wzh0531/nuedc-2026-h-ball-control/THIRD_PARTY_NOTICES.md

# 第三方软件与资料声明

本仓库包含或依赖以下第三方内容。其版权属于原作者，使用者应同时遵守相应许可条款。

## 逐飞 MSPM0G3507 开源库

- 版权所有 © 2022 成都逐飞科技有限公司（SEEKFREE）
- 许可证：GNU General Public License v3.0 or later
- 位置：`firmware/mspm0/libraries/zf_*`、部分 `project/user` 文件及相关工程配置
- 原始版权声明已保留在源文件头部。

## Texas Instruments MSPM0 SDK / DriverLib

- 版权所有 © Texas Instruments Incorporated
- 位置：`firmware/mspm0/libraries/sdk`
- 各文件适用的 BSD 类许可或 TI 许可声明以文件头部原文为准。

## Arm CMSIS

- 版权所有 © Arm Limited（及相关贡献者）
- 位置：`firmware/mspm0/libraries/sdk/third_party/CMSIS`
- 各文件许可声明以文件头部原文为准。

## MaixPy / Sipeed 运行时

`firmware/maixcam` 中的程序调用 MaixPy API，但仓库不分发 MaixPy 固件本身。MaixPy
及设备固件遵循其上游许可条款。

## 赛题与模型

- `docs/reference/H题_车载平衡滚球运动控制系统.pdf` 为竞赛题目资料，仅为复现和学习归档；
- `firmware/maixcam/model_310817.cvimodel` 为本项目使用的部署模型；训练数据未随仓库发布。

如发现版权归属或许可标注不完整，请提交 Issue 说明具体文件，本项目将及时补充或移除。
