wzh0531/nuedc-2026-h-ball-control/docs/flowcharts/01_主程序流程图.png

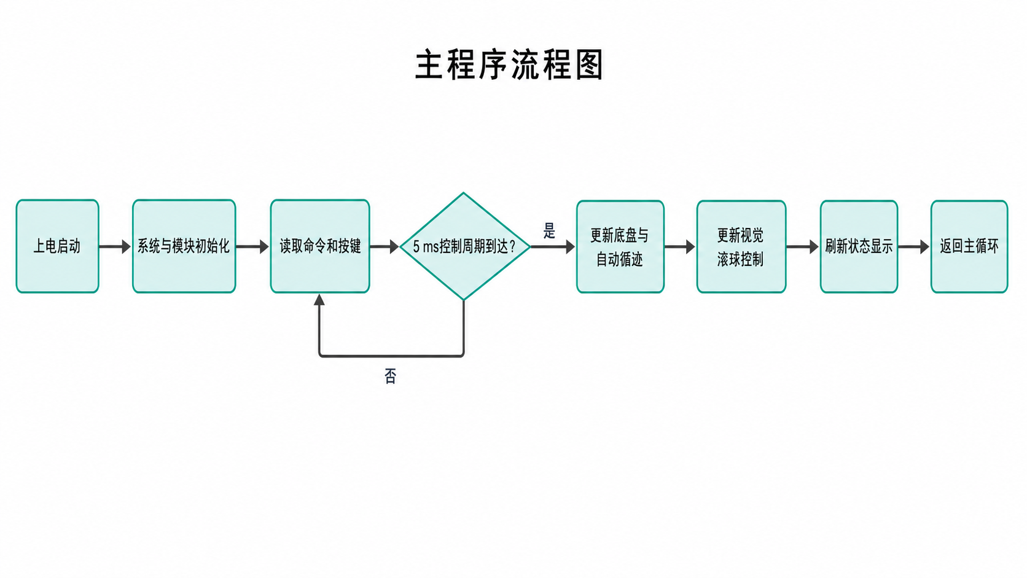
docs/flowcharts/01_主程序流程图.png
