wzh0531/nuedc-2026-h-ball-control/docs/flowcharts/02_自动循迹子程序.png

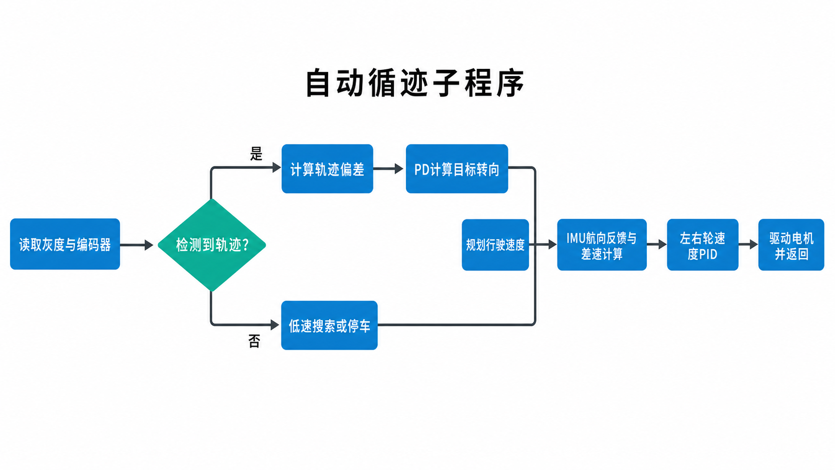
docs/flowcharts/02_自动循迹子程序.png
