wzh0531/nuedc-2026-h-ball-control/docs/flowcharts/03_视觉追踪子程序.png

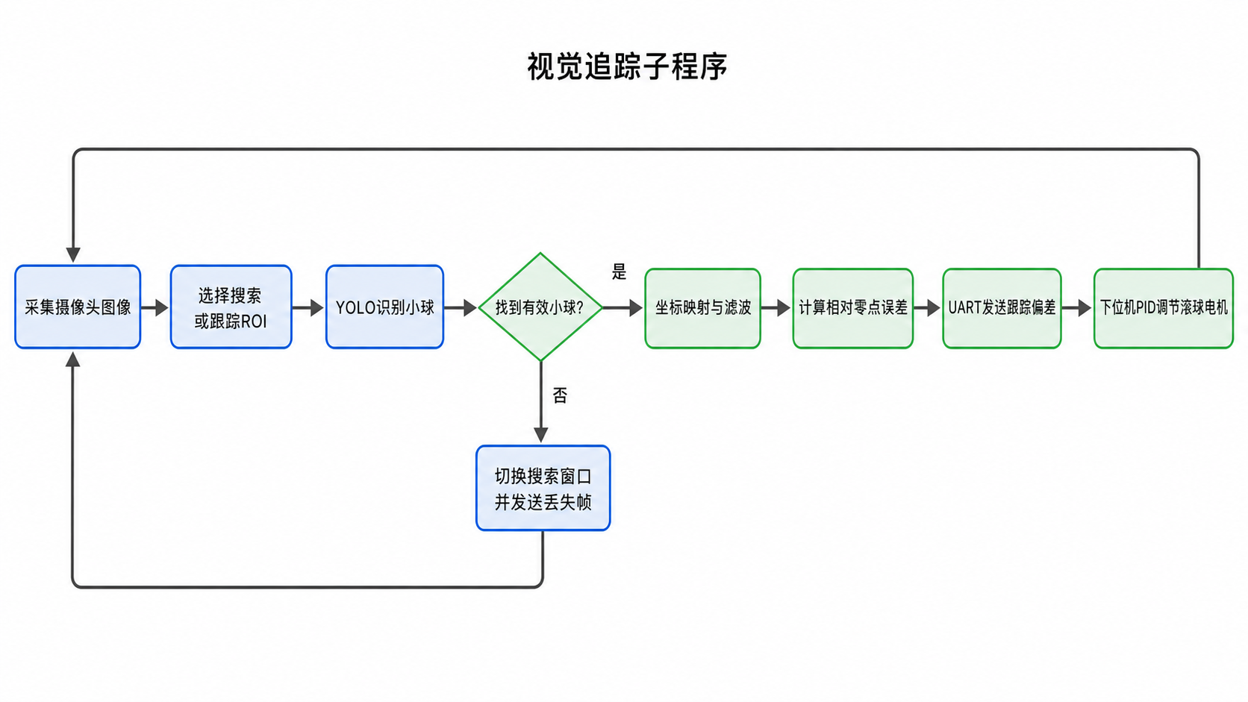
docs/flowcharts/03_视觉追踪子程序.png
