wzh0531/nuedc-2026-h-ball-control/docs/flowcharts/04_全局信号流向图.png

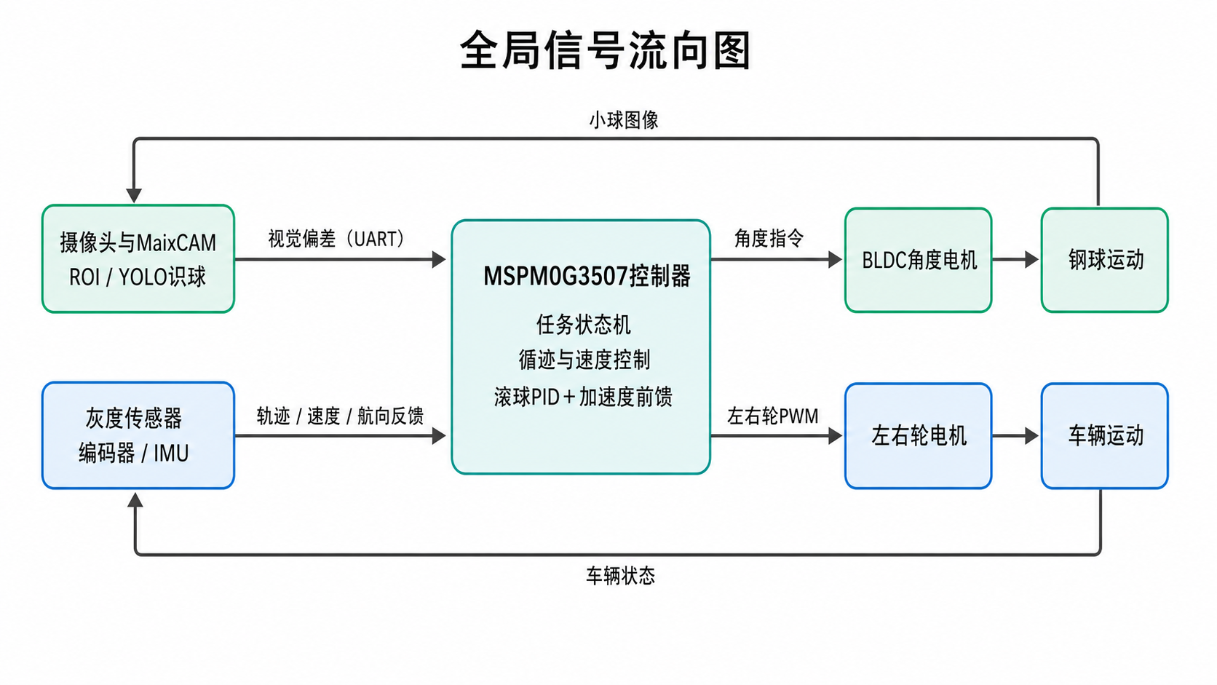
docs/flowcharts/04_全局信号流向图.png
