wzh0531/nuedc-2026-h-ball-control/docs/MSPM0_底盘固件使用与调试.md

# 2026 H 题 MSPM0G3507 底盘固件使用与调试手册

## 1. 当前交付状态

底盘固件位于：

`firmware/mspm0`

工程基线为 Keil MDK + ARMCLANG + 逐飞 MSPM0G3507 开源库。底盘代码只放在
`project/code` 与 `project/user`，未修改 `libraries` 底层。

当前已实现：

- 双轮差速底盘与扩展板板载 TB6612；
- MG513XP28_12V 电机，13 PPR、AB 双相四倍频；
- 左右轮 5 ms 独立速度 PI；
- 单前置感为八路灰度串行读取与循迹外环；
- IMU660RA Z 轴角速度内环；
- 任务 2～6 选择与底盘运动状态机；
- A 点停车、通过 B 后停车、越过 A 后停车；
- S 曲线限加速度、弯道降速、丢线与堵转保护；
- 四个板载按键、0.96 英寸 SSD1306 兼容 OLED、UART0 调参命令；
- Keil 工程、SysConfig 与完整编译依赖。

最后一次全量构建：

- MCU：MSPM0G3507；
- 工具链：ARMCLANG 6.21；
- 结果：0 Error、0 Warning；
- Flash 镜像估算：61,288 B，约 59.9 KiB；
- RAM：12,616 B，约 12.3 KiB。

编译通过只证明接口和链接正确。电机方向、编码器方向、灰度位序、轮径、
A/B 点距离和 PID 必须在实车上完成下面的标定。

## 2. 关键机械参数

| 参数 | 当前值 |
|---|---:|
| 底盘形式 | 双轮差速 |
| 建议车体 | 300 mm × 220 mm |
| 轮距 | 170 mm |
| 驱动轮有效直径 | 65 mm |
| 灰度阵列前伸量 | 轮轴前 80～100 mm |
| 电机减速比 | 28:1 |
| 编码器 | 13 PPR，AB 双相 |
| 软件计数方式 | A/B 两相双边沿，四倍频 |
| 每轮计数 | 13 × 4 × 28 = 1456 count/rev |
| 每计数距离 | 约 0.14025 mm |
| 额定理论线速度 | 约 1.021 m/s |

装车承载后轮胎会变形，实际轮径不能只用 65 mm 名义值。应通过定距行驶修正
`car_config.h` 中的 `CAR_METERS_PER_COUNT`。

## 3. 接线与资源表

### 3.1 电机与编码器

| 功能 | MSPM0 引脚 | 说明 |
|---|---|---|
| 左电机 PWM | PB14 / TIMA0_CH0 | 20 kHz |
| 左电机 IN1 | PB9 | TB6612 AIN1 |
| 左电机 IN2 | PB10 | TB6612 AIN2 |
| 右电机 PWM | PA7 / TIMA0_CH1 | 20 kHz |
| 右电机 IN1 | PB7 | TB6612 BIN1 |
| 右电机 IN2 | PB6 | TB6612 BIN2 |
| 左编码器 A | PB11 | 双边沿中断 |
| 左编码器 B | PB12 | 双边沿中断 |
| 右编码器 A | PB4 | 双边沿中断 |
| 右编码器 B | PB5 | 双边沿中断 |

扩展板 `STBY` 已固定为高，软件无法通过 STBY 切断驱动。故障状态采用
PWM=0、IN1=IN2=0。

### 3.2 传感器、显示与按键

| 功能 | MSPM0 引脚 | 说明 |
|---|---|---|
| IMU660RA SCL | PB2 | 逐飞软件 I²C |
| IMU660RA SDA | PB3 | 逐飞软件 I²C |
| 八路灰度 DAT | PA25 | 沿用已通过实车巡线验证的 mspcar 接线 |
| 八路灰度 CLK | PA27 | 沿用已通过实车巡线验证的 mspcar 接线 |
| OLED SDA | PA0 | 扩展板 0.96 英寸 OLED 接口，SSD1306 兼容软件 I²C |
| OLED SCL | PA1 | 扩展板 0.96 英寸 OLED 接口，SSD1306 兼容软件 I²C |
| KEY1 | PB0 | 上拉输入、低有效 |
| KEY2 | PB22 | 上拉输入、低有效 |
| KEY3 | PB18 | 上拉输入、低有效 |
| KEY4 | PB24 | 上拉输入、低有效 |

当前实车辅助板已测得原始串行协议为 `0=黑、1=白`；程序归一化后的八位
`black_mask` 保持 `1=黑`。实测首个串行位就是车体物理最左侧探头，因此不反转位序。

### 3.3 通信与调度

| 功能 | 引脚/资源 | 当前状态 |
|---|---|---|
| 调试串口 TX/RX | PA10 / PA11，UART0 | 已使用，115200 8N1 |
| MaixCAM TX/RX | PB15 / PB16，UART2 | 已保留，底盘模块暂不初始化 |
| 1 ms 调度 | TIMG12 | 已使用 |
| 电机 PWM | TIMA0 CH0/CH1 | 已使用 |
| 编码器中断 | GPIOA_INT_IRQn | 优先级 0 |
| UART0 调试接收中断 | UART0_INT_IRQn | 优先级 1 |
| 1 ms 调度中断 | TIMG12_INT_IRQn | 优先级 2 |

MaixCAM 通信由滚球控制模块接入时应使用 PB15/PB16，不要占用 UART0 调参口。

UART0 按逐飞库的 MCU 定义接线：`PA10=MCU TX`、`PA11=MCU RX`。USB 转串口
必须交叉连接，即模块 `RX→PA10`、模块 `TX→PA11`，并共地；不要只按转接板线缆
上的 TX/RX 字样同名直连。

## 4. 按键功能

| 按键 | READY/FINISHED | RUNNING | FAULT |
|---|---|---|---|
| KEY1 短按 | 选择上一个任务，2←…←6 循环 | 无操作 | 无操作 |
| KEY2 短按 | 选择下一个任务，2→…→6 循环 | 无操作 | 无操作 |
| KEY3 短按 | READY时启动；任务3在FINISHED时复位回READY | 任务3中可提前结束（调试备用） | 无操作 |
| KEY4 短按 | 急停并锁定故障 | 按下约 10 ms 即急停，不等待松手 | 保持故障 |
| KEY4 长按 1 s | READY 时进入急停；FINISHED 时复位 | 已在约 10 ms 时急停，持续按住不会复位 | 人工复位到 READY |

推荐比赛操作：

1. 上电时保持小车和 IMU 静止；
2. OLED 会显示约 2.25 s 的 `CAL`；在变为 `READY` 前不要移动小车；
3. OLED 显示 `READY` 后，用 KEY1/KEY2 选择任务；
4. 放到起点并确认灰度阵列压在线上；
5. 按 KEY3 启动；
6. 发生异常立即按 KEY4；
7. 排除故障后长按 KEY4 复位。

运行中 KEY4 连续低电平达到两个 5 ms 扫描周期后立即急停。本次按压会一直锁定到
按键松开，防止持续按住 1 s 时把刚产生的急停故障误复位。要复位必须先松开 KEY4，
排除故障，再重新长按。

## 5. OLED 显示

OLED 每 100 ms 重建状态页。赛题要求按键启动时开始计时并显示时间，因此车辆
处于 `RUNNING/PRE_BRAKE` 时，每 100 ms 只通过软件 I²C 发送第 3 行 `TIME`
所在的一页；其余页面暂停物理刷新。回到 `FINISHED/FAULT/READY` 且无控制
积压后恢复完整界面逐页发送。若某周期已有控制积压，本次时间页刷新会被跳过，
不得为了显示放宽控制超时保护。

| 行 | 内容 |
|---:|---|
| 1 | H CHASSIS、当前任务号 |
| 2 | INIT/CAL/READY/RUN/BRAKE/FINISH/FAULT |
| 3 | 当前运行时间 |
| 4 | 赛题有效结果时间（RES） |
| 5 | 累计距离、左右轮速 |
| 6 | 灰度掩码、横向误差 |
| 7 | 左右 PWM |
| 8 | 故障位 |

第 3 行 `TIME` 显示当前运行时间，第 4 行 `RES` 显示按题意锁存的有效结果时间：
任务 2/3 在完成时锁存，任务 4 在车体测试点通过 B 时锁存，任务 5/6 在车体
测试点通过 A 时锁存。OLED 本体应不超过题目规定的 2 英寸。

## 6. 任务 2～6 的底盘动作

### 6.1 任务 2：一圈后停在 A 点

- 本问不要求钢球，可不放球；滚球服务忽略视觉误差、球PID和加速度前馈，持续命令F32C为`0°`水平位；
- F32C上电后先以单圈绝对位置模式回到内部保存的`0°`，等待500 ms后清除多圈角度，再进入多圈限速位置模式；首次必须无球确认保存零点与机械水平一致；
- 从 A 点顺时针起步；
- 正常循迹阶段保持 `0.37 m/s` 单一巡航目标，不再区分直线档与弯道档；
- 超过 5.5 m 后进入预减速；
- 同时满足里程超过 5.5 m、时间超过 10 s、至少 4 路连续 3 帧为黑，
  才确认返回 A 点；
- 确认后继续行驶“灰度阵列到车体测试点”的距离，再减速停车；
- A 点只锁存一次，不会因宽黑线连续多帧重复更新停车目标。

应实测并修改：

- `CAR_A_GATE_DISTANCE_M`；
- `CAR_A_GATE_TIME_MS`；
- `CAR_SENSOR_TO_TEST_POINT_M`。

当前两次动态日志表明普通弯道可连续出现 `black=3`，真正 A 点附近则连续
23 帧出现 `black=4`。因此停车阈值设为 4，并继续保留动态证据缓冲：

- 仅在任务 2/5/6 且里程、时间门均打开后，以 5 ms 周期记录；
- 记录 `time/distance/mask/black/line_valid/line_error/yaw_rate`；
- 缓冲共 256 帧，持续滚动保留最近约 1.28 s；`black>=3` 只置候选标记，
  不再提前冻结；
- 车辆进入 FINISHED 或 FAULT 且电机停机后冻结，随后 `RESET` 仍保留；
- 控制周期只写 RAM，不使用串口；停车后发送 `ALOG` 导出。

实车采集步骤：

```text
TASK 2
START
```

让小车动态通过第一次 A 点。若仍未自动停车，应在通过后尽快发送 `STOP`，等待
`FINISH` 后发送：

```text
STATS
ALOG
```

回传完整 `ALOG`。`triggered=1` 仅表示门控后至少出现过一次 `black>=3`；
`frozen=1` 表示车辆已进入 FINISHED 或 FAULT 并完成停机。若 `triggered=0`，
表示门控后未出现三探头黑线。日志始终是停车前最近约 1.28 s，因此通过 A 点后
应尽快发送 `STOP`。只有动态数据能稳定区分 A 点与普通弯道三探头压线时，下一版
才修改停车判据。

### 6.2 任务 3：底盘静止

- READY时滚球目标为中心`0 cm`，不会提前移动到`+5 cm`；
- KEY3启动后开始计时，目标依次为`+5 cm`、`-5 cm`；
- 每个端点需满足位置误差不超过`0.5 cm`、速度不超过`1.0 cm/s`并连续5个新视觉帧稳定；
- `-5 cm`稳定后自动结束并锁存`RES`，无需第二次按键；
- 启动后电机保持 PWM=0；
- OLED 继续计时；
- 运行中KEY3仍可提前结束，仅作为调试备用；
- 滚球摆杆独立动作，底盘不会参与补偿移动。

### 6.3 任务 4：A 到 B

- 从 A 点顺时针出发；
- 默认以 `0.24 m/s` 单一巡航目标行驶；
- 1.32 m 后进入目标距离控制；
- 停车目标与 1.50 m 的 B 点重合，不配置过 B 额外行驶距离；
- 车体指定测试点到达 B 时锁存 `RES`，随后按 S 曲线把剩余速度降至零；
- 任务 4 使用零距离完成容差，不能套用其他任务的 1.5 cm 提前完成窗口。

`1.50 m` 是当前软件的初始定距值，必须用实际赛道测得 A 到 B 沿线距离后修改
`CAR_TASK4_B_DISTANCE_M`。当前 `CAR_TASK4_PASS_B_EXTRA_DISTANCE_M=0.000f`；
`CAR_TASK4_PRE_BRAKE_DISTANCE_M` 只决定何时开始接近目标，不增加停车目标距离。
零配置余量不等于实车绝对零越过量，轮胎、惯性和 0.04 m/s 贴近速度仍须实车标定。

### 6.4 任务 5、6：一圈并越过 A 点

- 两个任务的底盘轨迹相同；
- 正常循迹阶段保持 `0.25 m/s` 单一巡航目标；
- 返回 A 点的确认条件与任务 2 相同；
- 前置灰度确认 A 线后，继续行驶 `CAR_SENSOR_TO_TEST_POINT_M`；
- 车体指定测试点真正越过 A 时才锁存 `RES`，不会在传感器先过线时提前停表；
- 测试点过 A 后继续前进 0.15 m，再平滑停车；
- 任务 5 的钢球中心控制、任务 6 的任意位置控制由滚球模块完成。

越过 A 点的距离由 `CAR_PASS_A_EXTRA_DISTANCE_M` 调整。

## 7. 控制周期与控制结构

TIMG12 每 1 ms 进入一次短回调，只累加时钟并置 5 ms 控制标志。主循环取标志后
执行完整控制，不在 ISR 中计算 PID、读 I²C 或打印。

每个 5 ms 周期依次执行：

1. 扫描按键，优先处理 KEY4 急停；
2. 原子读取左右编码器增量；
3. 读取八路灰度；
4. `CAL` 状态推进一帧 IMU 标定，运行状态更新 Z 轴角速度；
5. 更新安全条件和任务状态机；
6. 更新 S 曲线速度规划；
7. 灰度误差经 PD 得到目标偏航角速度；
8. IMU 角速度环得到左右轮差速量；
9. 左右轮速度 PI 输出 PWM，并累计非阻塞统计；
10. 判断停车条件并分步刷新一页 OLED。

轮速使用最近 3 个采样的移动平均。速度环包含前馈、积分限幅和条件积分抗饱和。
基础速度规划同时限制加速度（0.30 m/s²）、减速度（0.35 m/s²）和加加速度
（1.20 m/s³），形成适配中轴线纵向滚球机构的离散 S 曲线。停车速度包络额外预留
7.5 cm jerk 制动裕量，进入裕量区后以不高于 0.04 m/s 连续贴近停车窗口，再按
S 曲线降至零，避免提前刹停后无法到点。该裕量仍需在摆杆和钢球满载后结合实车
制动距离复核。

正常循迹不再根据横向误差或偏航角速度切换快慢档：任务2保持 `0.37 m/s`，任务4
保持 `0.24 m/s`，任务5/6保持 `0.25 m/s`。仅起步、任务2接近 A 的必要预减速、
目标距离停车、人工 `STOP` 和短时丢线搜索会改变基础速度，所有正常变化仍经过同一
S 曲线。堵转、长时间丢线、控制超时和 KEY4 属于安全故障，仍立即切断电机输出。

## 8. 安全边界

### 8.1 TB6612

用户已确认接受使用板载 TB6612 的硬件风险。软件采用：

- PWM 上限 65%，逐飞标度为 ±6500；
- 禁止直接反转；
- 换向前至少一个 5 ms 控制周期为零输出；
- 默认不使用短刹车；
- 故障时 PWM=0、方向脚全低。

MG513XP28_12V 的堵转电流约 3.2 A，已达到 TB6612 短脉冲绝对上限。
软件保护不能替代硬件限流，禁止故意锁死电机测试。

### 8.2 堵转和编码器

PWM 绝对值超过 25% 且任一编码器连续 3 个控制周期无有效边沿，约 15 ms 后锁定
对应堵转故障。安全层只统计上一周期已经实际施加的 PWM；当前周期刚计算出的新
PWM 从下一次 5 ms 采样开始计时，避免把尚未作用于电机的首帧提前算成堵转。

AB 相出现跨两位的非法跳变时累计错误。单个 5 ms 周期新增非法跳变超过阈值，
锁定编码器信号故障。

### 8.3 丢线

- 小于 100 ms：以 0.10 m/s 沿最后转向方向搜索；
- 100～200 ms：停止向前推进，保留最后方向的低速原地搜索；
- 达到 200 ms：锁定丢线故障并进入 FAULT。

### 8.4 控制超时

主循环若在 RUNNING/PRE_BRAKE 中一次积压超过两个 5 ms 控制周期，锁定控制超时
故障。READY/FINISHED/FAULT 等停车状态下的长调试输出只丢弃陈旧周期、保留一次
最新采样，不会误锁故障。上电欢迎日志在调度器启动前发送。串口不得在运行中连续
打印高速数据，OLED 使用分步刷新也是为了限制控制延迟。

## 9. 故障位

| 位值 | 含义 |
|---:|---|
| `0x00000001` | 左电机堵转 |
| `0x00000002` | 右电机堵转 |
| `0x00000004` | 丢线超过 200 ms |
| `0x00000008` | IMU 未就绪 |
| `0x00000010` | 5 ms 控制任务积压 |
| `0x00000020` | 编码器非法跳变过多 |
| `0x00000040` | KEY4 人工急停 |

FAULT 必须排除原因后长按 KEY4 或发送 `RESET` 人工复位。

## 10. UART0 命令

串口参数：115200、8 数据位、无校验、1 停止位。

| 命令 | 作用 |
|---|---|
| `HELP` | 显示帮助 |
| `STATUS` | 输出任务、状态、轮速、里程、灰度、PWM、故障等 |
| `STATS` | 停车后输出整段运行的速度、循迹、角速度和 PWM 统计 |
| `ALOG` | 停车后按时间顺序导出 A 点动态灰度缓冲 |
| `TASK 2`～`TASK 6` | 选择任务 |
| `START` | 启动 |
| `STOP` | 请求平滑停车，返回 `OK STOP WAIT FINISH` |
| `RESET` | FAULT/FINISHED 状态人工复位 |
| `SPEED 0.22` | 临时设置基础速度，0 恢复默认 |
| `PID SPEED kp ki kd` | 设置左右速度环参数 |
| `PID LINE kp kd` | 设置灰度外环参数 |
| `PID YAW kp ki kd` | 设置角速度内环参数 |
| `BALL` | 输出滚球位置、速度、目标、PID/静摩擦补偿/前馈/实际角度及任务3阶段；phase 0/1/2/3分别为待机、去+5、去-5、完成 |
| `BALL UART` | 输出F32C反馈请求、UART1收发计数、反馈帧错误分类及最后一个9字节候选帧 |
| `BALL PID pos_p vel_p vel_i` | 设置滚球位置外环P、速度中环PI |
| `BALL STICK start pos progress` | 设置自适应破静摩擦起始角、位置误差阈值和有效位移阈值；`start=0`可关闭 |
| `BALL BOOST max delay ramp` | 设置自适应补偿最大角、卡住确认时间（ms）和爬升速率（deg/s） |
| `BALL SHAKE reverse push brake` | 设置卡滞反向制动角、正向轻推时间和反向制动时间（ms） |
| `BALL FF gain` | 设置底盘规划加速度前馈增益；静止基线调试使用0 |
| `BALL FFLEAD ms` | 设置规划加速度前馈的jerk前瞻时间，范围0～300 ms；默认150 ms |
| `BALL TARGET -10..10` | 停车状态设置手动滚球目标，单位cm；建议仅在TASK 3、READY下使用 |
| `BALL TARGET OFF` | 退出手动目标，恢复当前任务自动目标 |
| `MOTOR left right ms` | READY 下短时开环电机测试 |
| `VEL left_mps right_mps ms` | READY 下限时运行纯轮速闭环；范围 0～0.35 m/s、200～3000 ms |
| `YAW base_mps rate_dps ms` | READY 下限时运行 IMU 偏航角速度闭环；速度 0.18～0.25 m/s、角速度 ±30°/s、200～3000 ms |
| `IMUCAL` | 停车状态重新静止标定 IMU；成功可从 IMU 故障恢复 |
| `ENCZ` | READY 下编码器清零 |
| `GRAY` | 单次读取灰度掩码 |

示例：

```text
STATUS
STATS
ALOG
TASK 2
SPEED 0.20
START
PID SPEED 7000 5000 0
VEL 0.20 0.20 2000
PID LINE 65 0.3
PID YAW 0.0024 0 0
YAW 0.20 20 1000
TASK 3
BALL FF 0
BALL PID 0.40 0.50 0
BALL LIMIT 2 8 15
BALL STICK 3.2 0.35 0.25
BALL BOOST 7.0 300 4.0
BALL SHAKE 2.4 120 120
BALL TARGET 0
BALL TARGET 5
BALL TARGET -5
BALL TARGET OFF
BALL FF 1.0
BALL FFLEAD 150
```

命令参数只保存在 RAM，复位后恢复 `car_config.h` 的默认值。本版已将确认参数固化为
`PID SPEED 7000 5000 0`、`PID YAW 0.0024 0 0`、`PID LINE 65 0.3`，重新烧录后
上电即生效；以后通过串口临时修改仍不会自动写入 Flash。

滚球默认参数根据静止实车结果固化为`BALL PID 0.40 0.50 0`、`BALL LIMIT 2 8 15`。
底盘规划加速度前馈默认为`BALL FF 1.0`、`BALL FFLEAD 150`。稳态使用
`atan(a_ref/g)`计算物理平衡角；当规划加速度幅值正在建立时，先按规划器jerk将加速度
前瞻150 ms再计算角度，以补偿摆杆执行滞后。0.30 m/s²稳态约1.75°，按1.20 m/s³
最大jerk建立时前瞻角约2.80°并被前馈限幅压到2.5°；加速度回落时不做反向前瞻，
`a_ref=0`严格输出0。全过程仍受前馈±2.5°和总角±8°限幅。
破静摩擦默认使用`BALL STICK 3.2 0.35 0.25`、`BALL BOOST 7 300 4`和
`BALL SHAKE 2.4 120 120`：位置误差大于0.35 cm且连续300 ms没有推进
0.25 cm时，先沿目标方向以3.2°起步并持4°/s小幅增加120 ms；推进
0.25 cm或时间到后立即反向2.4°制动120 ms，再以80°/s回到PID目标并冷却
500 ms。`stick_phase=0/1/2`分别表示空闲/正向轻推/反向制动。全过程仍受±8°
总限幅，不绕过任务2、丢球、停机和FAULT。

逐飞 UART0 的打印为阻塞发送。底盘处于 RUNNING/PRE_BRAKE 时，固件只接受
`STOP`，其他命令返回 `ERR BUSY RUN`，防止长篇 `STATUS/HELP` 输出破坏 5 ms
控制周期。PID、速度、灰度查询和 IMU 标定均应在停车状态执行。

发送 `STOP` 后状态先进入 PRE_BRAKE，必须等待 OLED 显示 `FINISH` 且电机停稳，
再发送 `STATS`。若在减速过程中立即发送 `STATS`，固件会返回 `ERR BUSY RUN`。

`STATUS` 中 `time` 是最终停车前持续递增的运行时间，`result` 是按赛题过线
口径锁存的有效结果时间，单位均为毫秒。

`STATS` 和 `ALOG` 均不在运行中打印。每次 `START`、`MOTOR`、`VEL` 或 `YAW`
自动清零统计与 A 点缓冲，FINISHED、FAULT 和随后 `RESET` 都保留结果，直到
下一次启动：

| 字段 | 含义 |
|---|---|
| `samples/duration` | 5 ms 控制样本数和统计时长 |
| `speed_mae=L,R` | 左右轮目标速度与实测速度的平均绝对误差，m/s |
| `speed_max=L,R` | 左右轮最大瞬时速度误差，包含起步和停车瞬态 |
| `wheel_diff=mean/max` | 左右实测轮速差；应在直线测试中判断 |
| `line_max` | 有效灰度测量的最大归一化横向误差 |
| `yaw_err=mean/max` | 目标与实测 Z 轴角速度的平均/最大绝对误差，°/s |
| `yaw_max` | 实测角速度绝对值峰值，°/s |
| `pwm_max` | 两轮 PWM 绝对值峰值，满量程为 6500 |
| `sat` | 任一轮达到 65% 软件上限的样本数 |
| `line_lost` | 灰度无有效黑线的 5 ms 样本数 |

上电后固件在 `CAL` 状态每 5 ms 采一帧，先用 400 帧计算零偏，再用 50 帧计算
平均绝对残差，全程约 2.25 s 且电机保持零输出。残差若超过 0.5°/s，固件不会
进入 READY。保持小车静止后再次发送 `IMUCAL`；标定成功时会清除 IMU 故障并
恢复到 READY。

逐飞当前 `imu660ra_get_gyro()` 没有向上返回单次 I²C ACK 状态，所以固件可以检测
上电自检失败和标定残差超限，但不能可靠地把运行中总线断线与合法的零角速度区分。
必须固定 IMU 插头并在架空状态做断线现象检查；本限制不是丢线或堵转保护的替代项。

## 11. 第一次上电顺序

### 11.1 不装轮或架空

1. 断开电机 12 V，只给主控供电；
2. 确认 OLED、串口、IMU 和灰度正常；
3. 依次遮挡八个探头并发送 `GRAY`；
4. 手转左轮一圈，`STATUS` 应增加约 +1456；
5. 手转右轮一圈，`STATUS` 应增加约 +1456；
6. 若符号错误，只改 `CAR_ENCODER_LEFT_SIGN/RIGHT_SIGN`；
7. 若物理左移时灰度误差符号相反，改 `CAR_GRAY_REVERSE_ORDER`，
   不要通过交换电机线掩盖。

### 11.2 低占空比电机方向

架空轮胎，接通电机电源，执行：

```text
MOTOR 1200 0 300
MOTOR 0 1200 300
```

两次都应使对应轮向车体前进方向旋转，并且 `STATUS` 编码器增量为正。

若电机方向错误，改 `CAR_MOTOR_LEFT_SIGN/RIGHT_SIGN`；若编码器方向错误，改编码器
符号。两类符号分别处理。

### 11.3 IMU

小车静止执行：

```text
IMUCAL
```

目标平均残差不超过 0.5°/s。手动令车体左转时，`yaw_rate` 的符号应与控制约定一致；
若相反，改 `CAR_IMU_YAW_SIGN`。

## 12. PID 调试步骤

### 12.1 只调左右速度环

`VEL` 直接给左右轮速度 PI 目标，不执行灰度外环和 IMU 角速度控制；灰度全白
也不会触发丢线故障，但堵转、编码器异常、PWM 上限、IMU 就绪门禁和 KEY4 急停
仍然有效。到达设定时间后自动进入 FINISHED 并令电机输出为零。

1. 首次架空执行 `RESET`、`PID SPEED 4000 0 0`、`VEL 0.15 0.15 1000`，
   确认两轮方向和反馈符号正确；
2. 放到直线空旷地面，每轮测试前执行 `RESET`，从
   `PID SPEED 4000 0 0`、`VEL 0.20 0.20 2000` 开始；
3. 等待自动停车后发送 `STATS`，记录完整三行及是否持续振荡；
4. 保持 `KI=0`，逐步调整 `KP`，以响应足够快且无持续振荡为准；
5. 再小步增加 `KI` 消除稳态误差；
6. 参数稳定后检查 0.20、0.30、0.35 m/s；
7. 最后才使用 `SPEED 0.20`、`START` 调角速度环和循迹环。

以 0.20 m/s、2 s 的 `VEL` 测试为例，
`speed_mae` 建议先做到左右均≤0.010 m/s，直线 `wheel_diff` 平均值≤0.006 m/s，
且 `sat=0`。`speed_max` 包含阶跃启动瞬态，不应单独用它判断稳态 PI。

先保证电机方向与编码器方向完全正确，再调 PID。符号错时调任何参数都没有意义。

2026-07-30 实车冻结速度环默认值为 `KP=7000、KI=5000、KD=0`。最终
`VEL 0.35 0.35 3000` 验证里程为 `1.0916 m`（相对理论 `1.050 m`
约 `+3.96%`），左右编码器差约 `1.36%`，`pwm_max=5276`、`sat=0`，
无故障。

### 12.2 调 IMU 角速度环

`YAW` 直接给定基础速度和目标 Z 轴角速度，保留左右轮速度 PI 与 IMU 角速度
闭环，但不使用灰度误差，也不会因全白而触发丢线故障。测试必须在空旷地面进行，
不要靠近赛道边缘。正目标约定为左转，此时右轮目标速度应高于左轮。

1. 保留已稳定的速度环，先使用默认 `PID YAW 0.0024 0 0`；
2. 执行 `YAW 0.20 20 1000`，车应平缓左转并在 1 s 后自动停车；
3. 停车后发送 `STATS`，记录 `yaw_err`、`yaw_max`、`pwm_max` 和有无摆动；
4. `RESET` 后执行 `YAW 0.20 -20 1000`，应以近似幅度向右转；
5. 确认正负方向都正确后，先只调 YAW `KP`，再加入少量 `KI`；
6. 目标是 `yaw_err` 下降且左右轮不高频摆动，两方向响应基本对称。

每次停车后比较 `STATS` 的 `yaw_err`。先让平均误差随 `KP` 增加而下降；若
`yaw_err` 最大值、`pwm_max` 或摆动同时明显上升，说明增益过大。只有长期存在
同方向稳态误差时才小步增加 `KI`。若正目标实际右转，或左转过程中出现越转越快，
先停止并检查左右轮差速方向与 `CAR_IMU_YAW_SIGN`，不要继续增加增益。

2026-07-30 实车冻结偏航环默认值为 `KP=0.0024、KI=0、KD=0`。在
`YAW 0.20 ±20 1000` 测试中，正/负方向的平均绝对误差分别为
`3.26/3.24°/s`，角速度峰值为 `20.97/19.06°/s`，`pwm_max=4178`、
`sat=0`；先左转再右转后车体航向恢复，说明差速与 IMU 符号一致。

### 12.3 调灰度外环

1. 使用 0.20～0.25 m/s；
2. 先只加 LINE `KP`，让车能回到线中心；
3. 出现左右摆动后增加适量 `KD`；
4. 无摆杆低速连续跑圈；
5. 提高到弯道 0.30～0.34 m/s、直线 0.40～0.45 m/s；
6. 满载重新微调，滚球摆杆和重心变化会改变底盘响应。

每次只修改一组参数，并记录命令、现象、`STATS` 全部输出和是否振荡。
正常完整圈应满足 `line_lost=0`；若不为 0，先处理安装高度、位序、速度或
循迹参数，不要仅放宽 200 ms 丢线故障阈值。

## 13. 定距与停车标定

1. 在地面标出 2 m 直线；
2. 清零编码器后低速行驶；
3. 用实测距离修正 `CAR_METERS_PER_COUNT`；
4. 至少正向重复 5 次取平均；
5. 在车体中心轴线上选定并标记题目要求的唯一测试点；
6. 测量灰度阵列中心到该测试点的实际纵向距离；
7. 修改 `CAR_SENSOR_TO_TEST_POINT_M`；
8. 在正式赛道测得 A 到 B 沿线距离；
9. 修改任务 4 的 B 点、过 B 停车余量和预减速距离；
10. 任务 2 连续停车 5 次，记录最大误差；
11. 目标最大偏差≤1.5 cm，为题目 2 cm 留余量。

## 14. 验收清单

- [x] 左右轮正转方向正确；
- [x] 左右编码器正转均为正；
- [x] 每轮一圈为 1456 count，允许手动测试误差不超过 1～2 count；
- [ ] 八个灰度探头位序和黑白电平正确；
- [ ] 物理左移与软件误差符号符合约定；
- [ ] IMU 静止残差≤0.5°/s；
- [ ] 0.20/0.30/0.35 m/s 轮速误差达标；
- [ ] 断开编码器信号可在约 15 ms 锁定故障；
- [ ] 全白 100 ms 内搜索、200 ms 后锁定故障；
- [ ] KEY4 短按和运行中长按均能急停；
- [ ] 任务 3 启动后底盘始终无输出；
- [ ] 任务 4 的车体测试点确实通过 B，`RES`≤8 s，随后才停车；
- [ ] 任务 2 单圈≤20 s且停车误差≤2 cm；
- [ ] 任务 5/6 的 `RES` 在车体测试点通过 A 时锁存且≤30 s；
- [ ] 连续 20 圈不丢线；
- [ ] 满载运行 10 分钟无复位、无热保护；
- [ ] TB6612 表面温度目标低于 70°C。

堵转保护测试只能断开编码器信号模拟，禁止真实锁死电机。

## 15. 构建和产物

Keil 工程：

`firmware/mspm0/project/mdk/SeekFree_MSPM0G3507_Device_Library.uvprojx`

固件产物：

- `project/mdk/Objects/SeekFree_MSPM0G3507_Device_Library.axf`
- `project/mdk/Objects/SeekFree_MSPM0G3507_Device_Library.hex`

Keil 中选择目标 `SeekFree_MSPM0G3507_Device_Library`，执行 Rebuild。烧录前再次确认
TB6612 电源、主控地、电机地共地，并把车轮架空。

### 15.1 PC 离线回归测试

在工作区根目录执行：

```powershell
& "firmware/mspm0/tests/run_chassis_state_machine_test.ps1" -ProjectRoot "firmware/mspm0"
```

脚本用 GCC 的 `-Wall -Wextra -Werror` 编译并运行正式业务模块，当前共 36 项：

- 20 项状态机/任务测试：任务选择、IMU 就绪门禁与恢复、非阻塞 CAL 成功/失败、
  任务 2～6、
  纯轮速闭环模式、偏航角速度闭环模式、A 点一次锁存、丢线、堵转、编码器异常和急停复位；其中包含任务 2/4/5/6
  从启动、加速、行驶、过线计时到停车的完整理想执行器仿真；
- 1 项规划测试：S 曲线加速度、减速度、跃度限制和无反向停车；
- 5 项驱动逻辑测试：AB 四倍频、非法跳变、TB6612 限幅/方向/换向保护、
  灰度极性与八种单点/双点/全白/全黑输入、按键消抖电平与长按；
- 6 项控制测试：三点轮速滤波、直行对称性、直接轮速目标旁路、直接角速度目标、
  误差符号、
  丢线方向记忆、偏航与 PWM 限幅、积分抗饱和。
- 1 项应用安全测试：直接链接正式 `car_app.c`，验证停车串口积压不误报、
  运行积压锁故障，以及 KEY4 约 10 ms 急停、按压锁和重新长按复位。
- 1 项运行统计测试：验证平均值、峰值、PWM 饱和、丢线计数和重新启动清零。
- 1 项真实 IMU 适配层测试：直接链接 `car_imu.c`，验证 400+50 帧非阻塞标定、
  残差拒绝、角速度滤波和停车后的同步重标定。
- 1 项真实 UART 命令测试：直接链接 `car_command.c`，验证有限浮点数、PID/SPEED、
  MOTOR/VEL/YAW 边界和运行状态命令门禁。

当前完整任务理想仿真结果：

| 任务 | `RES` | 最终里程 | 软件判定 |
|---:|---:|---:|---|
| 2 | 18.555 s | 6.151 m | `0.37 m/s` 恒定巡航，一圈后停在 A，≤20 s |
| 4 | 7.920 s | 1.503 m | `0.24 m/s` 恒定巡航，停车目标等于 B，零配置余量，≤8 s |
| 5 | 25.125 s | 6.283 m | `0.25 m/s` 恒定巡航，车体测试点过 A 后停车，≤30 s |
| 6 | 25.125 s | 6.283 m | `0.25 m/s` 恒定巡航，车体测试点过 A 后停车，≤30 s |

测试产物只生成在工作区 `tmp/test-artifacts`，不会烧录或访问硬件。完整任务仿真
在直线与两个半圆中保持各任务的单一巡航目标，但仍假设轮速完全跟随目标且循迹无
额外摆动；它只能证明任务状态、里程和计时链能够闭环，
不能代替实车电机方向、灰度左右位序、IMU 安装方向、动力学及控制参数验收。

## 16. 模块文件索引

| 文件 | 职责 |
|---|---|
| `car_board.h` | 天猛星扩展板资源映射 |
| `car_config.h` | 整车、控制、安全与赛道参数 |
| `car_motor.c/.h` | TB6612 PWM、方向、换向保护 |
| `car_encoder.c/.h` | AB 双相四倍频与非法跳变统计 |
| `car_gray.c/.h` | 八路串行采集、位序和加权误差 |
| `car_imu.c/.h` | IMU660RA 400+50 帧非阻塞标定、残差门禁和偏航角速度滤波 |
| `car_pid.c/.h` | 通用 PID 与抗积分饱和 |
| `car_control.c/.h` | 速度、灰度、角速度三层控制 |
| `car_planner.c/.h` | 加速度、减速度与跃度限制的 S 曲线规划 |
| `car_safety.c/.h` | 堵转、丢线、编码器和 IMU 保护 |
| `car_scheduler.c/.h` | 1 ms 时基和 5 ms 任务标志 |
| `car_telemetry.c/.h` | 控制周期非阻塞统计和停车后 PID 诊断 |
| `car_chassis.c/.h` | 对外接口、任务 2～6 和状态机 |
| `car_keys.c/.h` | 四键消抖、短按、长按 |
| `car_display.c/.h` | 0.96 英寸 SSD1306 兼容 OLED 状态和计时显示 |
| `car_command.c/.h` | UART0 命令与在线调参 |
| `car_app.c/.h` | 应用初始化与主循环调度 |

## 17. 第一次联调回传表

首次只做架空和低速测试，不要直接跑整圈。把下面内容原样复制并填写后发回，即可
据此判断应改方向系数、轮径还是 PID：

```text
1. 上电 IMUCAL：
   bias=___-0.0477_____  residual=__0.0507______ deg/s  是否进入 READY：是

2. 手转编码器：
   左轮向前一圈 count=____-1483,0____  负
   右轮向前一圈 count=____0,-1482____  负

3. 架空 MOTOR 800 0 500：
   左轮方向=向前  编码器是否增加：是，但为负
   MOTOR 0 800 500：
   右轮方向=向前  编码器是否增加：是，但为负

4. 灰度 GRAY：
   全白 mask=0x00
   黑线在物理最左 mask=0x01
   黑线在中心 mask=0x18
   黑线在物理最右 mask=0x80
   A 点宽黑线 mask=0x________（随摆放位置变化） black=3

5. 低速直行：
   SPEED 0.20、START 后实际 2 m 行驶距离=________ m
   左轮是否明显更快：是/否
   直行是否向左/向右/基本直

6. 低速循迹：
   入弯方向是否正确：是/否
   现象=反向逃线/左右摆动/转向不足/基本稳定
   当前 PID SPEED=________
   当前 PID LINE=________
   当前 PID YAW=________

7. 停车后 STATS（请粘贴完整三行）：
   ________________________________________________
   ________________________________________________
   ________________________________________________
```

若第 2～4 项有任何方向或位序错误，先修改 `car_config.h` 中相应的 `SIGN` 或
`CAR_GRAY_REVERSE_ORDER`，不要开始调 PID。只有编码器、灰度和 IMU 符号全部正确，
才进入速度环、循迹外环和偏航内环的逐层整定。
